saturn691/Fyrryx/server/src/buzzer.cpp

/*
 * Copyright (c) 2019, ArduinoGetStarted.com. All rights reserved.
 *
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
 * - Redistributions of source code must retain the above copyright
 *   notice, this list of conditions and the following disclaimer.
 *
 * - Redistributions in binary form must reproduce the above copyright
 *   notice, this list of conditions and the following disclaimer in the
 *   documentation and/or other materials provided with the distribution.
 *
 * - Neither the name of the ArduinoGetStarted.com nor the names of its
 *   contributors may be used to endorse or promote products derived from
 *   this software without specific prior written permission.
 *
 * THIS SOFTWARE IS PROVIDED BY ARDUINOGETSTARTED.COM "AS IS" AND ANY EXPRESS OR
 * IMPLIED WARRANTIES, INCLUDING, BUT NOT LIMITED TO, THE IMPLIED
 * WARRANTIES OF MERCHANTABILITY AND FITNESS FOR A PARTICULAR PURPOSE ARE
 * DISCLAIMED. IN NO EVENT SHALL ARDUINOGETSTARTED.COM BE LIABLE FOR ANY DIRECT,
 * INDIRECT, INCIDENTAL, SPECIAL, EXEMPLARY, OR CONSEQUENTIAL DAMAGES
 * (INCLUDING, BUT NOT LIMITED TO, PROCUREMENT OF SUBSTITUTE GOODS OR
 * SERVICES; LOSS OF USE, DATA, OR PROFITS; OR BUSINESS INTERRUPTION)
 * HOWEVER CAUSED AND ON ANY THEORY OF LIABILITY, WHETHER IN CONTRACT,
 * STRICT LIABILITY, OR TORT (INCLUDING NEGLIGENCE OR OTHERWISE) ARISING
 * IN ANY WAY OUT OF THE USE OF THIS SOFTWARE, EVEN IF ADVISED OF THE
 * POSSIBILITY OF SUCH DAMAGE.
 */

#include <buzzer.h>

int ezBuzzer::introMelody[] = {NOTE_CS5, NOTE_DS5, NOTE_DS5, NOTE_F5, NOTE_GS5, NOTE_FS5, NOTE_F5, NOTE_DS5, NOTE_CS5, NOTE_DS5, REST, NOTE_DS4, NOTE_CS4};
int ezBuzzer::introRhythm[] = {6, 10, 6, 6, 1, 1, 1, 1, 6, 10, 4, 4, 4};
int ezBuzzer::chorusMelody[] =  
	{ NOTE_GS4, NOTE_AS4, NOTE_CS5, NOTE_AS4,
	NOTE_F5, NOTE_F5, NOTE_DS5, NOTE_GS4, NOTE_AS4, NOTE_CS5, NOTE_AS4, NOTE_DS5, NOTE_DS5, NOTE_CS5, NOTE_C5, NOTE_AS4,
	NOTE_GS4, NOTE_AS4, NOTE_CS5, NOTE_AS4,
	NOTE_CS5, NOTE_DS5, NOTE_C5, NOTE_AS4, NOTE_GS4, NOTE_GS4, NOTE_GS4, NOTE_DS5, NOTE_CS5 };
int ezBuzzer::chorusRhythm[] = 
	{1, 1, 1, 1,
	3, 3, 6, 1, 1, 1, 1, 3, 3, 3, 1, 2,
	1, 1, 1, 1,
	3, 3, 3, 1, 2, 2, 2, 4, 8};

ezBuzzer::ezBuzzer(int pin) {
	_buzzerPin   = pin;
	_buzzerState = BUZZER_IDLE;

	_delayTime = 0;
	_beepTime  = 0;

	_startTime = 0;

	_melody = 0;
	_noteDurations = 0;
	_melodyLength  = 0;
	_melodyIndex   = 0;
	_notePauseTime = 0;

	pinMode(_buzzerPin, OUTPUT);
}

void ezBuzzer::stop(void){
	noTone(_buzzerPin);

	_buzzerState = BUZZER_IDLE;
}

void ezBuzzer::beep(unsigned long beepTime) {
	beep(beepTime, 0);
}

void ezBuzzer::beep(unsigned long beepTime, unsigned long delay) {
	_delayTime = delay;
	_beepTime  = beepTime;
	_buzzerState = BUZZER_BEEP_DELAY;
	_startTime = millis();
}

void ezBuzzer::playMelody(int *melody, int *noteDurations, int length) {
	_melody = melody;
	_noteDurations = noteDurations;
	_melodyLength  = length;
	_melodyIndex   = 0;
	_notePauseTime = 0;

	_buzzerState = BUZZER_MELODY;
	_startTime = millis();
}

int ezBuzzer::getState(void) {
	return _buzzerState;
}

void ezBuzzer::playIntro(void) {
    int length = sizeof(introRhythm) / sizeof(int);

    if (getState() == BUZZER_IDLE) {
        playMelody(introMelody, introRhythm, length);
    }
}

void ezBuzzer::playChorus(void) {
    int length = sizeof(chorusRhythm) / sizeof(int);

    if (_buzzerState == BUZZER_IDLE) {
        playMelody(chorusMelody, chorusRhythm, length);
    }
}

void ezBuzzer::loop(void) {

	switch(_buzzerState) {
		case BUZZER_IDLE:
			break;

		case BUZZER_BEEP_DELAY:
			if ((unsigned long)(millis() - _startTime) >= _delayTime) {
				_buzzerState = BUZZER_BEEPING;
				_startTime = millis();

				tone(_buzzerPin, NOTE_A4);
			}

			break;

		case BUZZER_BEEPING:
			if ((unsigned long)(millis() - _startTime) >= _beepTime) {
				_buzzerState = BUZZER_IDLE;
				noTone(_buzzerPin);
			}

			break;

		case BUZZER_MELODY:
			if(_melodyIndex < _melodyLength) {
				if(!_notePauseTime) {
					// to calculate the note duration, take the length of a semiquaver * note value (in semiquavers)
					int duration = beatlength * _noteDurations[_melodyIndex];
					tone(_buzzerPin, _melody[_melodyIndex], duration);

					// to distinguish the notes, set a minimum time between them.
					// the note's duration + 30% seems to work well:
					_notePauseTime = duration * beatseparationconstant;
					_startTime = millis();
				}

				if ((unsigned long)(millis() - _startTime) >= _notePauseTime) {
					noTone(_buzzerPin); // stop the tone playing:
					_notePauseTime = 0;
					_melodyIndex++; // play next node
				}
			} 
            else {
				noTone(_buzzerPin);
				_buzzerState = BUZZER_IDLE;
			}

			break;

		default:
			break;
	}
}
