saturn691/Fyrryx/(commit log)

2023-05-19 Introduced new UDP code- bugs present
    [main.ino]
2023-05-19 Introduced new buggy UDP code
    [metro-starter-arduino.ino]
2023-05-23 Fixed PlatformIO compile issues
    [main.ino]
2023-05-24 Added boilerplate code for magnetic field
2023-05-25 updated magnetic field detection
2023-06-12 Fixed compatibility issues between buzzer/field
    [main.ino]
2023-06-18 Added calibrate functions
